mkoseli2523/4-bit-image-comparator/implementation/and/layout/thumbnail_128x128.png

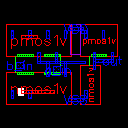
implementation/and/layout/thumbnail_128x128.png
