mkoseli2523/4-bit-image-comparator/implementation/and/schematic/thumbnail_128x128.png

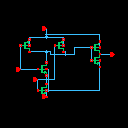
implementation/and/schematic/thumbnail_128x128.png
