mkoseli2523/4-bit-image-comparator/implementation/and/symbol/thumbnail_128x128.png

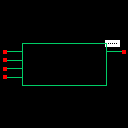
implementation/and/symbol/thumbnail_128x128.png
