mkoseli2523/4-bit-image-comparator/implementation/clk_deskew/schematic/thumbnail_128x128.png

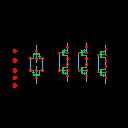
implementation/clk_deskew/schematic/thumbnail_128x128.png
