mkoseli2523/4-bit-image-comparator/implementation/combined3/layout/thumbnail_128x128.png

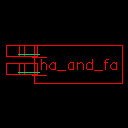
implementation/combined3/layout/thumbnail_128x128.png
