mkoseli2523/4-bit-image-comparator/implementation/combined3/schematic/thumbnail_128x128.png

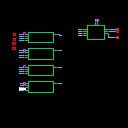
implementation/combined3/schematic/thumbnail_128x128.png
