mkoseli2523/4-bit-image-comparator/implementation/f4/schematic/thumbnail_128x128.png

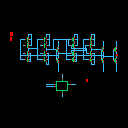
implementation/f4/schematic/thumbnail_128x128.png
