mkoseli2523/4-bit-image-comparator/implementation/f4v2/symbol/thumbnail_128x128.png

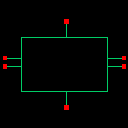
implementation/f4v2/symbol/thumbnail_128x128.png
