mkoseli2523/4-bit-image-comparator/implementation/full_adder/schematic/thumbnail_128x128.png

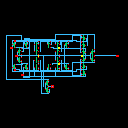
implementation/full_adder/schematic/thumbnail_128x128.png
