mkoseli2523/4-bit-image-comparator/implementation/ha_and_fa/layout/thumbnail_128x128.png

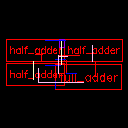
implementation/ha_and_fa/layout/thumbnail_128x128.png
