mkoseli2523/4-bit-image-comparator/implementation/ha_and_fa/symbol/thumbnail_128x128.png

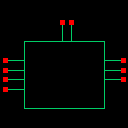
implementation/ha_and_fa/symbol/thumbnail_128x128.png
