mkoseli2523/4-bit-image-comparator/implementation/half_adder/layout/thumbnail_128x128.png

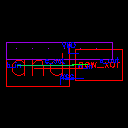
implementation/half_adder/layout/thumbnail_128x128.png
