mkoseli2523/4-bit-image-comparator/implementation/inv/schematic/thumbnail_128x128.png

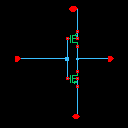
implementation/inv/schematic/thumbnail_128x128.png
