mkoseli2523/4-bit-image-comparator/implementation/inverter/layout/thumbnail_128x128.png

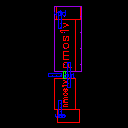
implementation/inverter/layout/thumbnail_128x128.png
