mkoseli2523/4-bit-image-comparator/implementation/inverter/schematic/thumbnail_128x128.png

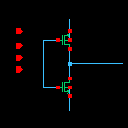
implementation/inverter/schematic/thumbnail_128x128.png
