mkoseli2523/4-bit-image-comparator/implementation/inverter_ha/schematic/thumbnail_128x128.png

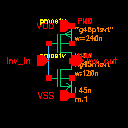
implementation/inverter_ha/schematic/thumbnail_128x128.png
