mkoseli2523/4-bit-image-comparator/implementation/layout/thumbnail_128x128.png

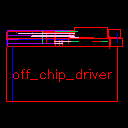
implementation/layout/thumbnail_128x128.png
