mkoseli2523/4-bit-image-comparator/implementation/level_shifter/layout/thumbnail_128x128.png

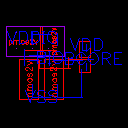
implementation/level_shifter/layout/thumbnail_128x128.png
