mkoseli2523/4-bit-image-comparator/implementation/level_shifter/schematic/thumbnail_128x128.png

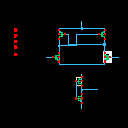
implementation/level_shifter/schematic/thumbnail_128x128.png
