mkoseli2523/4-bit-image-comparator/implementation/mux/layout/thumbnail_128x128.png

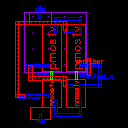
implementation/mux/layout/thumbnail_128x128.png
