mkoseli2523/4-bit-image-comparator/implementation/mux/schematic/thumbnail_128x128.png

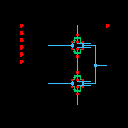
implementation/mux/schematic/thumbnail_128x128.png
