mkoseli2523/4-bit-image-comparator/implementation/NAND/layout/thumbnail_128x128.png

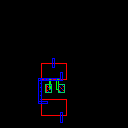
implementation/NAND/layout/thumbnail_128x128.png
