mkoseli2523/4-bit-image-comparator/implementation/NAND/schematic/thumbnail_128x128.png

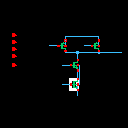
implementation/NAND/schematic/thumbnail_128x128.png
