mkoseli2523/4-bit-image-comparator/implementation/new_xor/schematic/thumbnail_128x128.png

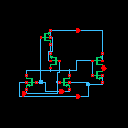
implementation/new_xor/schematic/thumbnail_128x128.png
