mkoseli2523/4-bit-image-comparator/implementation/off_chip_driver/schematic/thumbnail_128x128.png

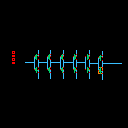
implementation/off_chip_driver/schematic/thumbnail_128x128.png
