mkoseli2523/4-bit-image-comparator/implementation/overall/schematic/thumbnail_128x128.png

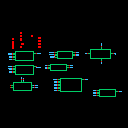
implementation/overall/schematic/thumbnail_128x128.png
