mkoseli2523/4-bit-image-comparator/implementation/pipo_2/layout/thumbnail_128x128.png

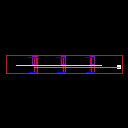
implementation/pipo_2/layout/thumbnail_128x128.png
