mkoseli2523/4-bit-image-comparator/implementation/pipo_2/pipo_2/schematic/thumbnail_128x128.png

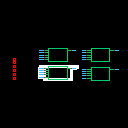
implementation/pipo_2/pipo_2/schematic/thumbnail_128x128.png
