mkoseli2523/4-bit-image-comparator/implementation/PISO_2/schematic/thumbnail_128x128.png

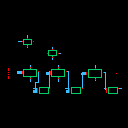
implementation/PISO_2/schematic/thumbnail_128x128.png
