mkoseli2523/4-bit-image-comparator/implementation/register_2/layout/thumbnail_128x128.png

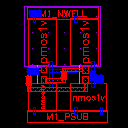
implementation/register_2/layout/thumbnail_128x128.png
