mkoseli2523/4-bit-image-comparator/implementation/register_2/schematic/thumbnail_128x128.png

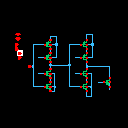
implementation/register_2/schematic/thumbnail_128x128.png
