mkoseli2523/4-bit-image-comparator/implementation/schematic/thumbnail_128x128.png

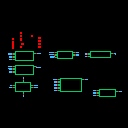
implementation/schematic/thumbnail_128x128.png
