mkoseli2523/4-bit-image-comparator/implementation/shift_signal_generator/schematic/thumbnail_128x128.png

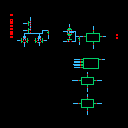
implementation/shift_signal_generator/schematic/thumbnail_128x128.png
