mkoseli2523/4-bit-image-comparator/implementation/overall.cir

project testbench
.lib '/class/ece482/gpdk045_mos' TT

$The following parameter can be modified.
.param TCK = 0.4167n

$The following parameters cannot be modified.
.param trf_ck = 5p
.param trf_ip_reset = 50p
.param CK_pw = 0.5*TCK
.param reset_delay = 0
.param reset_delay2 = 25*TCK
.param reset_pw = 0.9n
.param reset_pw2 = 3n
.param sim_end = 50*TCK
.param input_delay = 0.5n
.param input_pw = 4*TCK

$Clock Buffer - You will clk as your clock signal
mnm1 clk_out net10 vss vss g45n1svt L=45e-9 W=960e-9 AD=134.4e-15 AS=134.4e-15 PD=2.2e-6 PS=2.2e-6 NRD=145.833e-3 NRS=145.833e-3 M=1
mnm0 net10 CK vss vss g45n1svt L=45e-9 W=240e-9 AD=33.6e-15 AS=33.6e-15 PD=760e-9 PS=760e-9 NRD=583.333e-3 NRS=583.333e-3 M=1
mpm1 clk_out net10 vdd vdd g45p1svt L=45e-9 W=1.92e-6 AD=268.8e-15 AS=268.8e-15 PD=4.12e-6 PS=4.12e-6 NRD=72.9167e-3 NRS=72.9167e-3 M=1
mpm0 net10 CK vdd vdd g45p1svt L=45e-9 W=480e-9 AD=67.2e-15 AS=67.2e-15 PD=1.24e-6 PS=1.24e-6 NRD=291.667e-3 NRS=291.667e-3 M=1

vX3 x3 0 PWL(0 0 'input_delay+0*trf_ip_reset+0*input_pw' 0 'input_delay+1*trf_ip_reset+0*input_pw' 1.1 'input_delay+1*trf_ip_reset+1*input_pw' 1.1 'input_delay+2*trf_ip_reset+1*input_pw' 0 'input_delay+2*trf_ip_reset+2*input_pw' 0 'input_delay+3*trf_ip_reset+2*input_pw' 1.1 'input_delay+3*trf_ip_reset+3*input_pw' 1.1  'input_delay+4*trf_ip_reset+3*input_pw' 0 'input_delay+4*trf_ip_reset+4*input_pw' 0 sim_end 0)
vX2 x2 0 PWL(0 0 'input_delay+0*trf_ip_reset+0*input_pw' 0 'input_delay+1*trf_ip_reset+0*input_pw' 1.1 'input_delay+1*trf_ip_reset+1*input_pw' 1.1 'input_delay+2*trf_ip_reset+1*input_pw' 1.1 'input_delay+2*trf_ip_reset+2*input_pw' 1.1 'input_delay+3*trf_ip_reset+2*input_pw' 1.1 'input_delay+3*trf_ip_reset+3*input_pw' 1.1  'input_delay+4*trf_ip_reset+3*input_pw' 0 'input_delay+4*trf_ip_reset+4*input_pw' 0 sim_end 0)
vX1 x1 0 PWL(0 0 'input_delay+0*trf_ip_reset+0*input_pw' 0 'input_delay+1*trf_ip_reset+0*input_pw' 0 'input_delay+1*trf_ip_reset+1*input_pw' 0 'input_delay+2*trf_ip_reset+1*input_pw' 1.1 'input_delay+2*trf_ip_reset+2*input_pw' 1.1 'input_delay+3*trf_ip_reset+2*input_pw' 0 'input_delay+3*trf_ip_reset+3*input_pw' 0  'input_delay+4*trf_ip_reset+3*input_pw' 0 'input_delay+4*trf_ip_reset+4*input_pw' 0 sim_end 0)
vX0 x0 0 PWL(0 0 'input_delay+0*trf_ip_reset+0*input_pw' 0 'input_delay+1*trf_ip_reset+0*input_pw' 1.1 'input_delay+1*trf_ip_reset+1*input_pw' 1.1 'input_delay+2*trf_ip_reset+1*input_pw' 0 'input_delay+2*trf_ip_reset+2*input_pw' 0 'input_delay+3*trf_ip_reset+2*input_pw' 0 'input_delay+3*trf_ip_reset+3*input_pw' 0  'input_delay+4*trf_ip_reset+3*input_pw' 1.1 'input_delay+4*trf_ip_reset+4*input_pw' 1.1 sim_end 1.1)
vY3 y3 0 PWL(0 0 'input_delay+0*trf_ip_reset+0*input_pw' 0 'input_delay+1*trf_ip_reset+0*input_pw' 0 'input_delay+1*trf_ip_reset+1*input_pw' 0 'input_delay+2*trf_ip_reset+1*input_pw' 0 'input_delay+2*trf_ip_reset+2*input_pw' 0 'input_delay+3*trf_ip_reset+2*input_pw' 1.1 'input_delay+3*trf_ip_reset+3*input_pw' 1.1  'input_delay+4*trf_ip_reset+3*input_pw' 1.1 'input_delay+4*trf_ip_reset+4*input_pw' 1.1 sim_end 1.1)
vY2 y2 0 PWL(0 0 'input_delay+0*trf_ip_reset+0*input_pw' 0 'input_delay+1*trf_ip_reset+0*input_pw' 1.1 sim_end 1.1)
vY1 y1 0 PWL(0 0 'input_delay+0*trf_ip_reset+0*input_pw' 0 'input_delay+1*trf_ip_reset+0*input_pw' 1.1 'input_delay+1*trf_ip_reset+1*input_pw' 1.1 'input_delay+2*trf_ip_reset+1*input_pw' 1.1 'input_delay+2*trf_ip_reset+2*input_pw' 1.1 'input_delay+3*trf_ip_reset+2*input_pw' 0 'input_delay+3*trf_ip_reset+3*input_pw' 0 'input_delay+4*trf_ip_reset+3*input_pw' 0 'input_delay+4*trf_ip_reset+4*input_pw' 0 sim_end 0)
vY0 y0 0 PWL(0 0 sim_end 0)

vCK CK 0 pulse(0 1.1 trf_ck trf_ck trf_ck CK_pw TCK)
vReset reset 0 PWL(0 1.1 reset_delay 1.1 'reset_delay+trf_ip_reset' 1.1 'reset_delay+reset_pw+trf_ip_reset' 1.1 'reset_delay+reset_pw+2*trf_ip_reset' 0 'reset_delay+reset_pw+2*trf_ip_reset+reset_delay2' 0 'reset_delay+reset_pw+3*trf_ip_reset+reset_delay2' 1.1 'reset_delay+reset_pw+reset_pw2+3*trf_ip_reset+reset_delay2' 1.1 'reset_delay+reset_pw+reset_pw2+4*trf_ip_reset+reset_delay2' 0 sim_end 0)

vVDDIO vdd_oc 0 1.8
vVDD vdd 0 1.1
vVSS vss 0 0
** Library name: proj
** Generated for: hspiceD
** Generated on: Dec  2 19:27:32 2024
** Design library name: proj
** Design cell name: overall
** Design view name: schematic
** Generated for: hspiceD
** Generated on: Dec  3 19:46:39 2024
** Design library name: proj
** Design cell name: overall
** Design view name: schematic


.TEMP 25.0
.OPTION
+    ARTIST=2
+    INGOLD=2
+    PARHIER=LOCAL
+    PSF=2

** Library name: proj
** Cell name: full_adder
** View name: schematic
.subckt full_adder a_in b_in c_in c_out gnd s_out vdd
mnm52 net1 a_in net11 gnd g45n1svt L=45e-9 W=120e-9 AD=16.8e-15 AS=16.8e-15 PD=520e-9 PS=520e-9 NRD=1.16667 NRS=1.16667 M=1
mnm66 net5 a_in net6 gnd g45n1svt L=45e-9 W=120e-9 AD=16.8e-15 AS=16.8e-15 PD=520e-9 PS=520e-9 NRD=1.16667 NRS=1.16667 M=1
mnm36 c_out net1 gnd gnd g45n1svt L=45e-9 W=120e-9 AD=16.8e-15 AS=16.8e-15 PD=520e-9 PS=520e-9 NRD=1.16667 NRS=1.16667 M=1
mnm51 net1 c_in net7 gnd g45n1svt L=45e-9 W=120e-9 AD=16.8e-15 AS=16.8e-15 PD=520e-9 PS=520e-9 NRD=1.16667 NRS=1.16667 M=1
mnm63 net12 c_in gnd gnd g45n1svt L=45e-9 W=120e-9 AD=16.8e-15 AS=16.8e-15 PD=520e-9 PS=520e-9 NRD=1.16667 NRS=1.16667 M=1
mnm62 net12 b_in gnd gnd g45n1svt L=45e-9 W=120e-9 AD=16.8e-15 AS=16.8e-15 PD=520e-9 PS=520e-9 NRD=1.16667 NRS=1.16667 M=1
mnm65 net2 c_in net5 gnd g45n1svt L=45e-9 W=120e-9 AD=16.8e-15 AS=16.8e-15 PD=520e-9 PS=520e-9 NRD=1.16667 NRS=1.16667 M=1
mnm67 net6 b_in gnd gnd g45n1svt L=45e-9 W=120e-9 AD=16.8e-15 AS=16.8e-15 PD=520e-9 PS=520e-9 NRD=1.16667 NRS=1.16667 M=1
mnm48 net11 b_in gnd gnd g45n1svt L=45e-9 W=120e-9 AD=16.8e-15 AS=16.8e-15 PD=520e-9 PS=520e-9 NRD=1.16667 NRS=1.16667 M=1
mnm37 s_out net2 gnd gnd g45n1svt L=45e-9 W=120e-9 AD=16.8e-15 AS=16.8e-15 PD=520e-9 PS=520e-9 NRD=1.16667 NRS=1.16667 M=1
mnm61 net12 a_in gnd gnd g45n1svt L=45e-9 W=120e-9 AD=16.8e-15 AS=16.8e-15 PD=520e-9 PS=520e-9 NRD=1.16667 NRS=1.16667 M=1
mnm64 net2 net1 net12 gnd g45n1svt L=45e-9 W=120e-9 AD=16.8e-15 AS=16.8e-15 PD=520e-9 PS=520e-9 NRD=1.16667 NRS=1.16667 M=1
mnm50 net7 a_in gnd gnd g45n1svt L=45e-9 W=120e-9 AD=16.8e-15 AS=16.8e-15 PD=520e-9 PS=520e-9 NRD=1.16667 NRS=1.16667 M=1
mnm49 net7 b_in gnd gnd g45n1svt L=45e-9 W=120e-9 AD=16.8e-15 AS=16.8e-15 PD=520e-9 PS=520e-9 NRD=1.16667 NRS=1.16667 M=1
mpm91 net2 c_in net4 vdd g45p1svt L=45e-9 W=240e-9 AD=33.6e-15 AS=33.6e-15 PD=760e-9 PS=760e-9 NRD=583.333e-3 NRS=583.333e-3 M=1
mpm66 net9 a_in vdd vdd g45p1svt L=45e-9 W=120e-9 AD=16.8e-15 AS=16.8e-15 PD=520e-9 PS=520e-9 NRD=1.16667 NRS=1.16667 M=1
mpm86 net13 b_in vdd vdd g45p1svt L=45e-9 W=240e-9 AD=33.6e-15 AS=33.6e-15 PD=760e-9 PS=760e-9 NRD=583.333e-3 NRS=583.333e-3 M=1
mpm87 net13 c_in vdd vdd g45p1svt L=45e-9 W=240e-9 AD=33.6e-15 AS=33.6e-15 PD=760e-9 PS=760e-9 NRD=583.333e-3 NRS=583.333e-3 M=1
mpm88 net2 net1 net13 vdd g45p1svt L=45e-9 W=240e-9 AD=33.6e-15 AS=33.6e-15 PD=760e-9 PS=760e-9 NRD=583.333e-3 NRS=583.333e-3 M=1
mpm90 net4 b_in net3 vdd g45p1svt L=45e-9 W=240e-9 AD=33.6e-15 AS=33.6e-15 PD=760e-9 PS=760e-9 NRD=583.333e-3 NRS=583.333e-3 M=1
mpm89 net3 a_in vdd vdd g45p1svt L=45e-9 W=240e-9 AD=33.6e-15 AS=33.6e-15 PD=760e-9 PS=760e-9 NRD=583.333e-3 NRS=583.333e-3 M=1
mpm49 s_out net2 vdd vdd g45p1svt L=45e-9 W=240e-9 AD=33.6e-15 AS=33.6e-15 PD=760e-9 PS=760e-9 NRD=583.333e-3 NRS=583.333e-3 M=1
mpm72 net1 c_in net9 vdd g45p1svt L=45e-9 W=120e-9 AD=16.8e-15 AS=16.8e-15 PD=520e-9 PS=520e-9 NRD=1.16667 NRS=1.16667 M=1
mpm83 net10 b_in vdd vdd g45p1svt L=45e-9 W=240e-9 AD=33.6e-15 AS=33.6e-15 PD=760e-9 PS=760e-9 NRD=583.333e-3 NRS=583.333e-3 M=1
mpm67 net9 b_in vdd vdd g45p1svt L=45e-9 W=120e-9 AD=16.8e-15 AS=16.8e-15 PD=520e-9 PS=520e-9 NRD=1.16667 NRS=1.16667 M=1
mpm84 net1 a_in net10 vdd g45p1svt L=45e-9 W=240e-9 AD=33.6e-15 AS=33.6e-15 PD=760e-9 PS=760e-9 NRD=583.333e-3 NRS=583.333e-3 M=1
mpm85 net13 a_in vdd vdd g45p1svt L=45e-9 W=240e-9 AD=33.6e-15 AS=33.6e-15 PD=760e-9 PS=760e-9 NRD=583.333e-3 NRS=583.333e-3 M=1
mpm48 c_out net1 vdd vdd g45p1svt L=45e-9 W=240e-9 AD=33.6e-15 AS=33.6e-15 PD=760e-9 PS=760e-9 NRD=583.333e-3 NRS=583.333e-3 M=1
.ends full_adder
** End of subcircuit definition.

** Library name: proj
** Cell name: and
** View name: schematic
.subckt and vdd vss a_in b_in out
mpm1 net1 b_in vdd vdd g45p1svt L=45e-9 W=960e-9 AD=134.4e-15 AS=134.4e-15 PD=2.2e-6 PS=2.2e-6 NRD=145.833e-3 NRS=145.833e-3 M=1
mpm0 net1 a_in vdd vdd g45p1svt L=45e-9 W=960e-9 AD=134.4e-15 AS=134.4e-15 PD=2.2e-6 PS=2.2e-6 NRD=145.833e-3 NRS=145.833e-3 M=1
mnm2 out net1 vss vss g45n1svt L=45e-9 W=480e-9 AD=67.2e-15 AS=67.2e-15 PD=1.24e-6 PS=1.24e-6 NRD=291.667e-3 NRS=291.667e-3 M=1
mnm0 net1 a_in net2 vss g45n1svt L=45e-9 W=960e-9 AD=134.4e-15 AS=134.4e-15 PD=2.2e-6 PS=2.2e-6 NRD=145.833e-3 NRS=145.833e-3 M=1
mnm1 net2 b_in vss vss g45n1svt L=45e-9 W=960e-9 AD=134.4e-15 AS=134.4e-15 PD=2.2e-6 PS=2.2e-6 NRD=145.833e-3 NRS=145.833e-3 M=1
mpm2 out net1 vdd vdd g45p1svt L=45e-9 W=960e-9 AD=134.4e-15 AS=134.4e-15 PD=2.2e-6 PS=2.2e-6 NRD=145.833e-3 NRS=145.833e-3 M=1
.ends and
** End of subcircuit definition.

** Library name: proj
** Cell name: xor
** View name: schematic
.subckt xor vdd vss a_in b_in xor_out
mnm12 net2 b_in vss vss g45n1svt L=45e-9 W=120e-9 AD=16.8e-15 AS=16.8e-15 PD=520e-9 PS=520e-9 NRD=1.16667 NRS=1.16667 M=1
mnm14 net6 b_in vss vss g45n1svt L=45e-9 W=120e-9 AD=16.8e-15 AS=16.8e-15 PD=520e-9 PS=520e-9 NRD=1.16667 NRS=1.16667 M=1
mnm17 net3 net2 vss vss g45n1svt L=45e-9 W=120e-9 AD=16.8e-15 AS=16.8e-15 PD=520e-9 PS=520e-9 NRD=1.16667 NRS=1.16667 M=1
mnm13 xor_out a_in net6 vss g45n1svt L=45e-9 W=120e-9 AD=16.8e-15 AS=16.8e-15 PD=520e-9 PS=520e-9 NRD=1.16667 NRS=1.16667 M=1
mnm15 net4 a_in vss vss g45n1svt L=45e-9 W=120e-9 AD=16.8e-15 AS=16.8e-15 PD=520e-9 PS=520e-9 NRD=1.16667 NRS=1.16667 M=1
mnm16 xor_out net4 net3 vss g45n1svt L=45e-9 W=120e-9 AD=16.8e-15 AS=16.8e-15 PD=520e-9 PS=520e-9 NRD=1.16667 NRS=1.16667 M=1
mpm2 xor_out net2 net1 vdd g45p1svt L=45e-9 W=240e-9 AD=33.6e-15 AS=33.6e-15 PD=760e-9 PS=760e-9 NRD=583.333e-3 NRS=583.333e-3 M=1
mpm0 net2 b_in vdd vdd g45p1svt L=45e-9 W=240e-9 AD=33.6e-15 AS=33.6e-15 PD=760e-9 PS=760e-9 NRD=583.333e-3 NRS=583.333e-3 M=1
mpm3 net5 net4 vdd vdd g45p1svt L=45e-9 W=240e-9 AD=33.6e-15 AS=33.6e-15 PD=760e-9 PS=760e-9 NRD=583.333e-3 NRS=583.333e-3 M=1
mpm5 net4 a_in vdd vdd g45p1svt L=45e-9 W=240e-9 AD=33.6e-15 AS=33.6e-15 PD=760e-9 PS=760e-9 NRD=583.333e-3 NRS=583.333e-3 M=1
mpm4 xor_out b_in net5 vdd g45p1svt L=45e-9 W=240e-9 AD=33.6e-15 AS=33.6e-15 PD=760e-9 PS=760e-9 NRD=583.333e-3 NRS=583.333e-3 M=1
mpm1 net1 a_in vdd vdd g45p1svt L=45e-9 W=240e-9 AD=33.6e-15 AS=33.6e-15 PD=760e-9 PS=760e-9 NRD=583.333e-3 NRS=583.333e-3 M=1
.ends xor
** End of subcircuit definition.

** Library name: proj
** Cell name: half_adder
** View name: schematic
.subckt half_adder vdd vss a_in b_in c_out s_out
xi11 vdd vss a_in b_in c_out and
xi16 vdd vss a_in b_in s_out xor
.ends half_adder
** End of subcircuit definition.

** Library name: proj
** Cell name: ha_and_fa
** View name: schematic
.subckt ha_and_fa vdd vss a0 a1 a2 a3 r0 r1 r2
xi22 net1 net2 net10 r2 vss r1 vdd full_adder
xi16 vdd vss net3 net9 net10 r0 half_adder
xi15 vdd vss a2 a3 net2 net9 half_adder
xi14 vdd vss a0 a1 net1 net3 half_adder
.ends ha_and_fa
** End of subcircuit definition.

** Library name: proj
** Cell name: new_xor
** View name: schematic
.subckt new_xor vdd vss a_in b_in xor_out
mpm2 xor_out net2 vdd vdd g45p1svt L=45e-9 W=480e-9 AD=67.2e-15 AS=67.2e-15 PD=1.24e-6 PS=1.24e-6 NRD=291.667e-3 NRS=291.667e-3 M=1
mpm1 net2 a_in net1 vdd g45p1svt L=45e-9 W=480e-9 AD=67.2e-15 AS=67.2e-15 PD=1.24e-6 PS=1.24e-6 NRD=291.667e-3 NRS=291.667e-3 M=1
mpm0 net1 b_in vdd vdd g45p1svt L=45e-9 W=480e-9 AD=67.2e-15 AS=67.2e-15 PD=1.24e-6 PS=1.24e-6 NRD=291.667e-3 NRS=291.667e-3 M=1
mnm2 xor_out net2 vss vss g45n1svt L=45e-9 W=240e-9 AD=33.6e-15 AS=33.6e-15 PD=760e-9 PS=760e-9 NRD=583.333e-3 NRS=583.333e-3 M=1
mnm1 net2 b_in a_in vss g45n1svt L=45e-9 W=240e-9 AD=33.6e-15 AS=33.6e-15 PD=760e-9 PS=760e-9 NRD=583.333e-3 NRS=583.333e-3 M=1
mnm0 net2 a_in b_in vss g45n1svt L=45e-9 W=240e-9 AD=33.6e-15 AS=33.6e-15 PD=760e-9 PS=760e-9 NRD=583.333e-3 NRS=583.333e-3 M=1
.ends new_xor
** End of subcircuit definition.

** Library name: proj
** Cell name: combined3
** View name: schematic
.subckt combined3 vdd vss r0 r1 r2 x<3> x<2> x<1> x<0> y<3> y<2> y<1> y<0>
xi4 vdd vss net1 net2 net3 net4 r0 r1 r2 ha_and_fa
xi3 vdd vss x<3> y<3> net4 new_xor
xi2 vdd vss x<2> y<2> net3 new_xor
xi1 vdd vss x<1> y<1> net2 new_xor
xi0 vdd vss x<0> y<0> net1 new_xor
.ends combined3
** End of subcircuit definition.

** Library name: proj
** Cell name: inv
** View name: schematic
.subckt inv vdd vss in out
mpm0 out in vdd vdd g45p1svt L=45e-9 W=240e-9 AD=33.6e-15 AS=33.6e-15 PD=760e-9 PS=760e-9 NRD=583.333e-3 NRS=583.333e-3 M=1
mnm0 out in vss vss g45n1svt L=45e-9 W=120e-9 AD=16.8e-15 AS=16.8e-15 PD=520e-9 PS=520e-9 NRD=1.16667 NRS=1.16667 M=1
.ends inv
** End of subcircuit definition.

** Library name: proj
** Cell name: NAND
** View name: schematic
.subckt NAND a b c vdd vss
mnm3 net1 b vss vss g45n1svt L=45e-9 W=120e-9 AD=16.8e-15 AS=16.8e-15 PD=520e-9 PS=520e-9 NRD=1.16667 NRS=1.16667 M=1
mnm0 c a net1 vss g45n1svt L=45e-9 W=120e-9 AD=16.8e-15 AS=16.8e-15 PD=520e-9 PS=520e-9 NRD=1.16667 NRS=1.16667 M=1
mpm1 c a vdd vdd g45p1svt L=45e-9 W=120e-9 AD=16.8e-15 AS=16.8e-15 PD=520e-9 PS=520e-9 NRD=1.16667 NRS=1.16667 M=1
mpm0 c b vdd vdd g45p1svt L=45e-9 W=120e-9 AD=16.8e-15 AS=16.8e-15 PD=520e-9 PS=520e-9 NRD=1.16667 NRS=1.16667 M=1
.ends NAND
** End of subcircuit definition.

** Library name: proj
** Cell name: register_2
** View name: schematic
.subckt register_2 clk clk_bar d q rst vdd vss
mpm3 net4 x vdd vdd g45p1svt L=45e-9 W=960e-9 AD='960e-9/ceil(95.9995e-3)<119.5e-9?(floor(ceil(95.9995e-3)/2.0)*(14.4e-15+(960e-9/ceil(95.9995e-3))*100e-9)+(ceil(95.9995e-3)/2-floor(ceil(95.9995e-3)/2)!=0?14.4e-15+(960e-9/ceil(95.9995e-3))*50e-9:0))/1:(floor(ceil(95.9995e-3)/2.0)*(110e-9*(960e-9/ceil(95.9995e-3)))+(ceil(95.9995e-3)/2-floor(ceil(95.9995e-3)/2)!=0?140e-9*(960e-9/ceil(95.9995e-3)):0))/1' AS='960e-9/ceil(95.9995e-3)<119.5e-9?(((14.4e-15+(960e-9/ceil(95.9995e-3))*50e-9)+floor((ceil(95.9995e-3)-1)/2.0)*(14.4e-15+(960e-9/ceil(95.9995e-3))*100e-9))+(ceil(95.9995e-3)/2-floor(ceil(95.9995e-3)/2)==0?14.4e-15+(960e-9/ceil(95.9995e-3))*50e-9:0))/1:((140e-9*(960e-9/ceil(95.9995e-3))+floor((ceil(95.9995e-3)-1)/2.0)*(110e-9*(960e-9/ceil(95.9995e-3))))+(ceil(95.9995e-3)/2-floor(ceil(95.9995e-3)/2)==0?140e-9*(960e-9/ceil(95.9995e-3)):0))/1'
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
mnm2 q clk net3 vss g45n1svt L=45e-9 W=480e-9 AD='480e-9/ceil(47.9995e-3)<119.5e-9?(floor(ceil(47.9995e-3)/2.0)*(14.4e-15+(480e-9/ceil(47.9995e-3))*100e-9)+(ceil(47.9995e-3)/2-floor(ceil(47.9995e-3)/2)!=0?14.4e-15+(480e-9/ceil(47.9995e-3))*50e-9:0))/1:(floor(ceil(47.9995e-3)/2.0)*(110e-9*(480e-9/ceil(47.9995e-3)))+(ceil(47.9995e-3)/2-floor(ceil(47.9995e-3)/2)!=0?140e-9*(480e-9/ceil(47.9995e-3)):0))/1' AS='480e-9/ceil(47.9995e-3)<119.5e-9?(((14.4e-15+(480e-9/ceil(47.9995e-3))*50e-9)+floor((ceil(47.9995e-3)-1)/2.0)*(14.4e-15+(480e-9/ceil(47.9995e-3))*100e-9))+(ceil(47.9995e-3)/2-floor(ceil(47.9995e-3)/2)==0?14.4e-15+(480e-9/ceil(47.9995e-3))*50e-9:0))/1:((140e-9*(480e-9/ceil(47.9995e-3))+floor((ceil(47.9995e-3)-1)/2.0)*(110e-9*(480e-9/ceil(47.9995e-3))))+(ceil(47.9995e-3)/2-floor(ceil(47.9995e-3)/2)==0?140e-9*(480e-9/ceil(47.9995e-3)):0))/1'
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
