mkoseli2523/4-bit-image-comparator/implementation/overall_2.cir

project testbench
.lib '/class/ece482/gpdk045_mos' SS

$The following parameter can be modified.
.param TCK = 0.4167n

$The following parameters cannot be modified.
.param trf_ck = 5p
.param trf_ip_reset = 50p
.param CK_pw = 0.5*TCK
.param reset_delay = 0
.param reset_delay2 = 25*TCK
.param reset_pw = 0.9n
.param reset_pw2 = 3n
.param sim_end = 50*TCK
.param input_delay = 0.5n
.param input_pw = 4*TCK
c_load q vss 10p
$Clock Buffer - You will clk_out as your clock signal
mnm1 clk_out net10 vss vss g45n1svt L=45e-9 W=960e-9 AD=134.4e-15 AS=134.4e-15 PD=2.2e-6 PS=2.2e-6 NRD=145.833e-3 NRS=145.833e-3 M=1
mnm0 net10 CK vss vss g45n1svt L=45e-9 W=240e-9 AD=33.6e-15 AS=33.6e-15 PD=760e-9 PS=760e-9 NRD=583.333e-3 NRS=583.333e-3 M=1
mpm1 clk_out net10 vdd vdd g45p1svt L=45e-9 W=1.92e-6 AD=268.8e-15 AS=268.8e-15 PD=4.12e-6 PS=4.12e-6 NRD=72.9167e-3 NRS=72.9167e-3 M=1
mpm0 net10 CK vdd vdd g45p1svt L=45e-9 W=480e-9 AD=67.2e-15 AS=67.2e-15 PD=1.24e-6 PS=1.24e-6 NRD=291.667e-3 NRS=291.667e-3 M=1

vX3 x3 0 PWL(0 0 'input_delay+0*trf_ip_reset+0*input_pw' 0 'input_delay+1*trf_ip_reset+0*input_pw' 1.1 'input_delay+1*trf_ip_reset+1*input_pw' 1.1 'input_delay+2*trf_ip_reset+1*input_pw' 0 'input_delay+2*trf_ip_reset+2*input_pw' 0 'input_delay+3*trf_ip_reset+2*input_pw' 1.1 'input_delay+3*trf_ip_reset+3*input_pw' 1.1  'input_delay+4*trf_ip_reset+3*input_pw' 0 'input_delay+4*trf_ip_reset+4*input_pw' 0 sim_end 0)
vX2 x2 0 PWL(0 0 'input_delay+0*trf_ip_reset+0*input_pw' 0 'input_delay+1*trf_ip_reset+0*input_pw' 1.1 'input_delay+1*trf_ip_reset+1*input_pw' 1.1 'input_delay+2*trf_ip_reset+1*input_pw' 1.1 'input_delay+2*trf_ip_reset+2*input_pw' 1.1 'input_delay+3*trf_ip_reset+2*input_pw' 1.1 'input_delay+3*trf_ip_reset+3*input_pw' 1.1  'input_delay+4*trf_ip_reset+3*input_pw' 0 'input_delay+4*trf_ip_reset+4*input_pw' 0 sim_end 0)
vX1 x1 0 PWL(0 0 'input_delay+0*trf_ip_reset+0*input_pw' 0 'input_delay+1*trf_ip_reset+0*input_pw' 0 'input_delay+1*trf_ip_reset+1*input_pw' 0 'input_delay+2*trf_ip_reset+1*input_pw' 1.1 'input_delay+2*trf_ip_reset+2*input_pw' 1.1 'input_delay+3*trf_ip_reset+2*input_pw' 0 'input_delay+3*trf_ip_reset+3*input_pw' 0  'input_delay+4*trf_ip_reset+3*input_pw' 0 'input_delay+4*trf_ip_reset+4*input_pw' 0 sim_end 0)
vX0 x0 0 PWL(0 0 'input_delay+0*trf_ip_reset+0*input_pw' 0 'input_delay+1*trf_ip_reset+0*input_pw' 1.1 'input_delay+1*trf_ip_reset+1*input_pw' 1.1 'input_delay+2*trf_ip_reset+1*input_pw' 0 'input_delay+2*trf_ip_reset+2*input_pw' 0 'input_delay+3*trf_ip_reset+2*input_pw' 0 'input_delay+3*trf_ip_reset+3*input_pw' 0  'input_delay+4*trf_ip_reset+3*input_pw' 1.1 'input_delay+4*trf_ip_reset+4*input_pw' 1.1 sim_end 1.1)
vY3 y3 0 PWL(0 0 'input_delay+0*trf_ip_reset+0*input_pw' 0 'input_delay+1*trf_ip_reset+0*input_pw' 0 'input_delay+1*trf_ip_reset+1*input_pw' 0 'input_delay+2*trf_ip_reset+1*input_pw' 0 'input_delay+2*trf_ip_reset+2*input_pw' 0 'input_delay+3*trf_ip_reset+2*input_pw' 1.1 'input_delay+3*trf_ip_reset+3*input_pw' 1.1  'input_delay+4*trf_ip_reset+3*input_pw' 1.1 'input_delay+4*trf_ip_reset+4*input_pw' 1.1 sim_end 1.1)
vY2 y2 0 PWL(0 0 'input_delay+0*trf_ip_reset+0*input_pw' 0 'input_delay+1*trf_ip_reset+0*input_pw' 1.1 sim_end 1.1)
vY1 y1 0 PWL(0 0 'input_delay+0*trf_ip_reset+0*input_pw' 0 'input_delay+1*trf_ip_reset+0*input_pw' 1.1 'input_delay+1*trf_ip_reset+1*input_pw' 1.1 'input_delay+2*trf_ip_reset+1*input_pw' 1.1 'input_delay+2*trf_ip_reset+2*input_pw' 1.1 'input_delay+3*trf_ip_reset+2*input_pw' 0 'input_delay+3*trf_ip_reset+3*input_pw' 0 'input_delay+4*trf_ip_reset+3*input_pw' 0 'input_delay+4*trf_ip_reset+4*input_pw' 0 sim_end 0)
vY0 y0 0 PWL(0 0 sim_end 0)

vCK CK 0 pulse(0 1.1 trf_ck trf_ck trf_ck CK_pw TCK)
vReset reset 0 PWL(0 1.1 reset_delay 1.1 'reset_delay+trf_ip_reset' 1.1 'reset_delay+reset_pw+trf_ip_reset' 1.1 'reset_delay+reset_pw+2*trf_ip_reset' 0 'reset_delay+reset_pw+2*trf_ip_reset+reset_delay2' 0 'reset_delay+reset_pw+3*trf_ip_reset+reset_delay2' 1.1 'reset_delay+reset_pw+reset_pw2+3*trf_ip_reset+reset_delay2' 1.1 'reset_delay+reset_pw+reset_pw2+4*trf_ip_reset+reset_delay2' 0 sim_end 0)

vVDDIO vdd_oc 0 1.8
vVDD VDD 0 1.1
vVSS VSS 0 0

.tran 0 sim_end

.option post


** Library name: proj
** Cell name: overall
** View name: av_extracted
c1 vdd vss 42.6597e-15
c2 x1 vss 218.102e-18
c3 x2 vss 218.596e-18
c4 x3 vss 219.942e-18
c5 clk_out vss 4.2588e-15
c6 q vss 77.2644e-15
c7 reset vss 6.1131e-15
c8 vdd_oc vss 57.7273e-15
c9 x0 vss 220.141e-18
c10 y0 vss 219.88e-18
c11 y1 vss 220.934e-18
c12 y2 vss 222.262e-18
c13 y3 vss 220.091e-18
c14 ck vss 1.15607e-15
c15 ck_bar vss 1.28069e-15
c16 r0 vss 1.09372e-15
c17 r1 vss 1.75287e-15
c18 r2 vss 1.75105e-15
c19 bcore vss 1.25857e-15
c20 shift vss 3.19942e-15
c21 _net7 vss 1.75395e-15
c22 _net6 vss 2.67081e-15
c23 _net5 vss 3.36949e-15
c24 _net4 vss 2.15186e-15
c25 _net3 vss 1.91742e-15
c26 _net2 vss 3.0314e-15
c27 _net1 vss 2.99188e-15
c28 _net0 vss 4.1288e-15
c29 clk_divided_four vss 8.40013e-15
c30 serial_in vss 1.69219e-15
c31 i10__i1__ck vss 1.07381e-15
c32 i10__i1__ck_bar vss 944.637e-18
c33 i10__i1__i1__net3 vss 108.648e-18
c34 i10__i1__i1__net5 vss 523.688e-18
c35 i10__i1__i1__net1 vss 107.28e-18
c36 i10__i1__i1__net2 vss 193.313e-18
c37 i10__i1__i1__net4 vss 192.767e-18
c38 i10__i1__i0__t_out vss 540.756e-18
c39 i10__i1__i0__clk_out vss 444.173e-18
c40 i10__i10__ck vss 1.16619e-15
c41 i10__i10__ck_bar vss 1.04367e-15
c42 i10__i10__i1__net3 vss 110.273e-18
c43 i10__i10__i1__net5 vss 527.338e-18
c44 i10__i10__i1__net1 vss 108.25e-18
c45 i10__i10__i1__net2 vss 195.073e-18
c46 i10__i10__i1__net4 vss 194.753e-18
c47 i10__i10__i0__t_out vss 541.229e-18
c48 i10__i10__i0__clk_out vss 446.451e-18
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
mi20__pm1 i20__net2 i20__net1 vdd_oc vdd_oc g45p2svt L=150e-9 W=3.565e-6 AD=534.75e-15 AS=534.75e-15 PD=7.43e-6 PS=7.43e-6 NRD=468.75e-3 NRS=468.75e-3 M=1
mi20__pm2_1__rcx i20__net3 i20__net2 vdd_oc vdd_oc g45p2svt L=150e-9 W=6.62e-6 AD=1.324e-12 AS=1.324e-12 PD=13.59e-6 PS=13.59e-6 NRD=468.75e-3 NRS=468.75e-3 M=1
mi20__pm2 vdd_oc i20__net2 i20__net3 vdd_oc g45p2svt L=150e-9 W=6.62e-6 AD=993e-15 AS=993e-15 PD=13.59e-6 PS=13.59e-6 NRD=468.75e-3 NRS=468.75e-3 M=1
mi20__pm3_4__rcx i20__net4 i20__net3 vdd_oc vdd_oc g45p2svt L=150e-9 W=9.835e-6 AD=1.967e-12 AS=1.967e-12 PD=20.02e-6 PS=20.02e-6 NRD=468.75e-3 NRS=468.75e-3 M=1
mi20__pm3_3__rcx vdd_oc i20__net3 i20__net4 vdd_oc g45p2svt L=150e-9 W=9.835e-6 AD=1.967e-12 AS=1.967e-12 PD=20.07e-6 PS=20.07e-6 NRD=468.75e-3 NRS=468.75e-3 M=1
mi20__pm3_2__rcx i20__net4 i20__net3 vdd_oc vdd_oc g45p2svt L=150e-9 W=9.835e-6 AD=1.967e-12 AS=1.967e-12 PD=20.07e-6 PS=20.07e-6 NRD=468.75e-3 NRS=468.75e-3 M=1
mi20__pm3_1__rcx vdd_oc i20__net3 i20__net4 vdd_oc g45p2svt L=150e-9 W=9.835e-6 AD=1.967e-12 AS=1.967e-12 PD=20.07e-6 PS=20.07e-6 NRD=468.75e-3 NRS=468.75e-3 M=1
mi20__pm3 i20__net4 i20__net3 vdd_oc vdd_oc g45p2svt L=150e-9 W=9.835e-6 AD=1.47525e-12 AS=1.47525e-12 PD=20.02e-6 PS=20.02e-6 NRD=468.75e-3 NRS=468.75e-3 M=1
mi21__m1 vdd_oc serial_in i21__bio_not vdd_oc g45p2svt L=150e-9 W=320e-9 AD=48e-15 AS=48e-15 PD=940e-9 PS=940e-9 NRD=468.75e-3 NRS=468.75e-3 M=1
mi21__m0 vdd_oc i21__bio_not serial_in vdd_oc g45p2svt L=150e-9 W=320e-9 AD=48e-15 AS=48e-15 PD=940e-9 PS=940e-9 NRD=468.75e-3 NRS=468.75e-3 M=1
mi10__i1__i1__pm2 _net4 i10__i1__ck_bar i10__i1__i1__net4 vdd g45p1svt L=45e-9 W=960e-9 AD=134.4e-15 AS=134.4e-15 PD=2.22e-6 PS=2.22e-6 NRD=1.16667 NRS=1.16667 M=1
mi10__i1__i1__pm3 i10__i1__i1__net4 i10__i1__i1__net5 vdd vdd g45p1svt L=45e-9 W=960e-9 AD=153.6e-15 AS=153.6e-15 PD=2.22e-6 PS=2.22e-6 NRD=1.16667 NRS=1.16667 M=1
mi10__i1__i1__pm1 i10__i1__i1__net5 i10__i1__ck i10__i1__i1__net2 vdd g45p1svt L=45e-9 W=960e-9 AD=134.4e-15 AS=134.4e-15 PD=2.22e-6 PS=2.22e-6 NRD=1.16667 NRS=1.16667 M=1
mi10__i1__i1__pm0 i10__i1__i1__net2 x3 vdd vdd g45p1svt L=45e-9 W=960e-9 AD=153.6e-15 AS=153.6e-15 PD=2.22e-6 PS=2.22e-6 NRD=1.16667 NRS=1.16667 M=1
mi10__i1__i0__pm5 vdd i10__i1__i0__clk_out i10__i1__ck vdd g45p1svt L=45e-9 W=960e-9 AD=134.4e-15 AS=134.4e-15 PD=2.2e-6 PS=2.2e-6 NRD=1.16667 NRS=1.16667 M=1
mi10__i1__i0__pm4 vdd clk_divided_four i10__i1__i0__clk_out vdd g45p1svt L=45e-9 W=960e-9 AD=134.4e-15 AS=134.4e-15 PD=2.2e-6 PS=2.2e-6 NRD=1.16667 NRS=1.16667 M=1
mi10__i1__i0__pm0 i10__i1__i0__t_out vss clk_divided_four vdd g45p1svt L=45e-9 W=960e-9 AD=134.4e-15 AS=134.4e-15 PD=2.2e-6 PS=2.2e-6 NRD=1.16667 NRS=1.16667 M=1
mi10__i1__i0__pm1 i10__i1__ck_bar i10__i1__i0__t_out vdd vdd g45p1svt L=45e-9 W=960e-9 AD=134.4e-15 AS=134.4e-15 PD=2.2e-6 PS=2.2e-6 NRD=1.16667 NRS=1.16667 M=1
mi10__i10__i1__pm2 _net7 i10__i10__ck_bar i10__i10__i1__net4 vdd g45p1svt L=45e-9 W=960e-9 AD=134.4e-15 AS=134.4e-15 PD=2.22e-6 PS=2.22e-6 NRD=1.16667 NRS=1.16667 M=1
mi10__i10__i1__pm3 i10__i10__i1__net4 i10__i10__i1__net5 vdd vdd g45p1svt L=45e-9 W=960e-9 AD=153.6e-15 AS=153.6e-15 PD=2.22e-6 PS=2.22e-6 NRD=1.16667 NRS=1.16667 M=1
mi10__i10__i1__pm1 i10__i10__i1__net5 i10__i10__ck i10__i10__i1__net2 vdd g45p1svt L=45e-9 W=960e-9 AD=134.4e-15 AS=134.4e-15 PD=2.22e-6 PS=2.22e-6 NRD=1.16667 NRS=1.16667 M=1
mi10__i10__i1__pm0 i10__i10__i1__net2 x0 vdd vdd g45p1svt L=45e-9 W=960e-9 AD=153.6e-15 AS=153.6e-15 PD=2.22e-6 PS=2.22e-6 NRD=1.16667 NRS=1.16667 M=1
mi10__i10__i0__pm5 vdd i10__i10__i0__clk_out i10__i10__ck vdd g45p1svt L=45e-9 W=960e-9 AD=134.4e-15 AS=134.4e-15 PD=2.2e-6 PS=2.2e-6 NRD=1.16667 NRS=1.16667 M=1
mi10__i10__i0__pm4 vdd clk_divided_four i10__i10__i0__clk_out vdd g45p1svt L=45e-9 W=960e-9 AD=134.4e-15 AS=134.4e-15 PD=2.2e-6 PS=2.2e-6 NRD=1.16667 NRS=1.16667 M=1
mi10__i10__i0__pm0 i10__i10__i0__t_out vss clk_divided_four vdd g45p1svt L=45e-9 W=960e-9 AD=134.4e-15 AS=134.4e-15 PD=2.2e-6 PS=2.2e-6 NRD=1.16667 NRS=1.16667 M=1
mi10__i10__i0__pm1 i10__i10__ck_bar i10__i10__i0__t_out vdd vdd g45p1svt L=45e-9 W=960e-9 AD=134.4e-15 AS=134.4e-15 PD=2.2e-6 PS=2.2e-6 NRD=1.16667 NRS=1.16667 M=1
mi10__i9__i1__pm2 _net6 i10__i9__ck_bar i10__i9__i1__net4 vdd g45p1svt L=45e-9 W=960e-9 AD=134.4e-15 AS=134.4e-15 PD=2.22e-6 PS=2.22e-6 NRD=1.16667 NRS=1.16667 M=1
mi10__i9__i1__pm3 i10__i9__i1__net4 i10__i9__i1__net5 vdd vdd g45p1svt L=45e-9 W=960e-9 AD=153.6e-15 AS=153.6e-15 PD=2.22e-6 PS=2.22e-6 NRD=1.16667 NRS=1.16667 M=1
mi10__i9__i1__pm1 i10__i9__i1__net5 i10__i9__ck i10__i9__i1__net2 vdd g45p1svt L=45e-9 W=960e-9 AD=134.4e-15 AS=134.4e-15 PD=2.22e-6 PS=2.22e-6 NRD=1.16667 NRS=1.16667 M=1
mi10__i9__i1__pm0 i10__i9__i1__net2 x1 vdd vdd g45p1svt L=45e-9 W=960e-9 AD=153.6e-15 AS=153.6e-15 PD=2.22e-6 PS=2.22e-6 NRD=1.16667 NRS=1.16667 M=1
mi10__i9__i0__pm5 vdd i10__i9__i0__clk_out i10__i9__ck vdd g45p1svt L=45e-9 W=960e-9 AD=134.4e-15 AS=134.4e-15 PD=2.2e-6 PS=2.2e-6 NRD=1.16667 NRS=1.16667 M=1
mi10__i9__i0__pm4 vdd clk_divided_four i10__i9__i0__clk_out vdd g45p1svt L=45e-9 W=960e-9 AD=134.4e-15 AS=134.4e-15 PD=2.2e-6 PS=2.2e-6 NRD=1.16667 NRS=1.16667 M=1
mi10__i9__i0__pm0 i10__i9__i0__t_out vss clk_divided_four vdd g45p1svt L=45e-9 W=960e-9 AD=134.4e-15 AS=134.4e-15 PD=2.2e-6 PS=2.2e-6 NRD=1.16667 NRS=1.16667 M=1
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
